DrMikeG/WiiBuzz/readme_img/IMG_20190727_184134.jpg

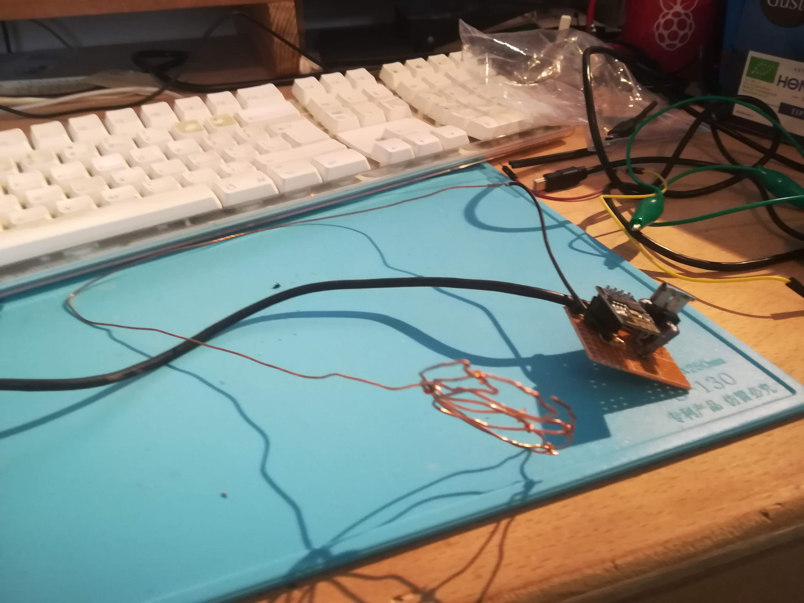
readme_img/IMG_20190727_184134.jpg
