DrMikeG/WiiBuzz/WebPageAP/WebPageAP.ino

// Load Wi-Fi library
#include <ESP8266WiFi.h>
#include <ESP8266mDNS.h>        // Include the mDNS library

const char* ssid = "VM4826469";
const char* password = "z8gGpcvqjhpk";

// Set web server port number to 8080
WiFiServer server(80);

// Variable to store the HTTP request
String header;

// Auxiliar variables to store the current output state
String output2State = "off";
String output0State = "on";

// Assign output variables to GPIO pins
const int output0 = 0;
const int output2 = 2;

//IPAddress local_IP(192,168,0,45);
//IPAddress gateway(192,168,0,9);
//IPAddress subnet(255,255,255,0);

void setup() {
  Serial.begin(115200);
  // Initialize the output variables as outputs
  pinMode(output2, OUTPUT);
  pinMode(output0, OUTPUT);
  // Set outputs to LOW
  digitalWrite(output2, LOW);
  digitalWrite(output0, HIGH);

  // Connect to Wi-Fi network with SSID and password
  //Serial.print("Connecting to ");
  //Serial.println(ssid);
  //WiFi.begin(ssid, password);
  //while (WiFi.status() != WL_CONNECTED) {
  //  delay(500);
  //  Serial.print(".");
  //}
  Serial.print("Setting soft-AP configuration ... ");
  Serial.println(WiFi.softAPConfig(local_IP, gateway, subnet) ? "Ready" : "Failed!");

  Serial.print("Setting soft-AP ... ");
  Serial.println(WiFi.softAP("ManCaveIOT","z8gGpcvqjhpk") ? "Ready" : "Failed!");

  Serial.print("Soft-AP IP address = ");
  Serial.println(WiFi.softAPIP());
  
  // Print local IP address and start web server
  //Serial.println("");
  //Serial.println("WiFi connected.");
  //Serial.println("IP address: ");
  //Serial.println(WiFi.localIP());
  //Serial.print("Setting soft-AP ... ");
  //boolean result = WiFi.softAP("ManCaveIOT","z8gGpcvqjhpk");
  //if(result == true)
  //{
  //  Serial.println("Ready");
  //}
  //else
  //{
   // Serial.println("Failed!");
  //}

  if (!MDNS.begin("mancave")) {             // Start the mDNS responder for mancave.local 
    Serial.println("Error setting up MDNS responder!");
  }
  Serial.println("mDNS responder started");
   // Add service to MDNS-SD
  MDNS.addService("http", "tcp", 80);
  server.begin();
}

void loop(){
  
  //Serial.printf("Stations connected = %d\n", WiFi.softAPgetStationNum());
  
  WiFiClient client = server.available();   // Listen for incoming clients

  if (client) {                             // If a new client connects,
    Serial.println("New Client.");          // print a message out in the serial port
    String currentLine = "";                // make a String to hold incoming data from the client
    while (client.connected()) {            // loop while the client's connected
      if (client.available()) {             // if there's bytes to read from the client,
        char c = client.read();             // read a byte, then
        Serial.write(c);                    // print it out the serial monitor
        header += c;
        if (c == '\n') {                    // if the byte is a newline character
          // if the current line is blank, you got two newline characters in a row.
          // that's the end of the client HTTP request, so send a response:
          if (currentLine.length() == 0) {
            // HTTP headers always start with a response code (e.g. HTTP/1.1 200 OK)
            // and a content-type so the client knows what's coming, then a blank line:
            client.println("HTTP/1.1 200 OK");
            client.println("Content-type:text/html");
            client.println("Connection: close");
            client.println();
            
            // turns the GPIOs on and off
            if (header.indexOf("GET /2/on") >= 0) {
              Serial.println("GPIO 2 on");
              output2State = "on";
              digitalWrite(output2, HIGH);
            } else if (header.indexOf("GET /2/off") >= 0) {
              Serial.println("GPIO 2 off");
              output2State = "off";
              digitalWrite(output2, LOW);
            } else if (header.indexOf("GET /0/on") >= 0) {
              Serial.println("GPIO 0 on");
              output0State = "on";
              digitalWrite(output0, HIGH);
            } else if (header.indexOf("GET /0/off") >= 0) {
              Serial.println("GPIO 0 off");
              output0State = "off";
              digitalWrite(output0, LOW);
            } else if (header.indexOf("GET /flash") >= 0) {
              // Flash 10 times

              for (int i=0; i < 20; i++)
              {
                digitalWrite(output0, LOW); // LEDS on              
                delay(350);
                Serial.println("FLASH!");
                digitalWrite(output0, HIGH); // LEDS off    
                delay(100);
              }
              
              Serial.println("GPIO 0 on");
              output0State = "on";
              digitalWrite(output0, HIGH);              
            }
            
            // Display the HTML web page
            client.println("<!DOCTYPE html><html>");
            client.println("<head><meta name=\"viewport\" content=\"width=device-width, initial-scale=1\">");
            client.println("<link rel=\"icon\" href=\"data:,\">");
            // CSS to style the on/off buttons 
            // Feel free to change the background-color and font-size attributes to fit your preferences
            client.println("<style>html { font-family: Helvetica; display: inline-block; margin: 0px auto; text-align: center;}");
            client.println(".button { background-color: #195B6A; border: none; color: white; padding: 16px 40px;");
            client.println("text-decoration: none; font-size: 30px; margin: 2px; cursor: pointer;}");
            client.println(".button2 {background-color: #77878A;}</style></head>");
            
            // Web Page Heading
            client.println("<body><h1>ESP8266 Web Server</h1>");
            
            // Display current state, and ON/OFF buttons for GPIO 2  
            client.println("<p>GPIO 2 - State " + output2State + "</p>");
            // If the output2State is off, it displays the ON button       
            if (output2State=="off") {
              client.println("<p><a href=\"/2/on\"><button class=\"button\">ON</button></a></p>");
            } else {
              client.println("<p><a href=\"/2/off\"><button class=\"button button2\">OFF</button></a></p>");
            } 
               
            // Display current state, and ON/OFF buttons for GPIO 4  
            client.println("<p>GPIO 0 - State " + output0State + "</p>");
            // If the output0State is off, it displays the ON button       
            if (output0State=="off") {
              client.println("<p><a href=\"/0/on\"><button class=\"button\">ON</button></a></p>");
            } else {
              client.println("<p><a href=\"/0/off\"><button class=\"button button2\">OFF</button></a></p>");
            }

            client.println("<p><a href=\"/flash\"><button class=\"button button3\">FLASH</button></a></p>");
            
            client.println("</body></html>");
            
            // The HTTP response ends with another blank line
            client.println();
            // Break out of the while loop
            break;
          } else { // if you got a newline, then clear currentLine
            currentLine = "";
          }
        } else if (c != '\r') {  // if you got anything else but a carriage return character,
          currentLine += c;      // add it to the end of the currentLine
        }
      }
    }
    // Clear the header variable
    header = "";
    // Close the connection
    client.stop();
    Serial.println("Client disconnected.");
    Serial.println("");
  }
}
