DrMikeG/WiiBuzz/(commit log)

2019-06-11 Updated Switch Client to flash onboard LED
2019-06-29 Solder on hex invertor
2019-07-05 Finished circuit and assembled torch
2019-07-25 changed switch URL to flash
2019-07-26 Work on capacitive switch code for nano and esp8266
2019-07-26 Included 3d printing images
2019-09-15 first arduino sketch not working
    [ArduinoRCSketch.ino]
2019-09-15 Saving pihit socket codes
2019-09-15 Notes on rc-switch codes
2019-09-15 Moved notes into ArduinoRC Readme
2019-09-16 Connecting to wifi and switching on pin 3
2019-10-05 Rejiging EspTwitterPoster to use PWM in loop()
2020-02-21 Fixing hang in EspRCSketch
    [EspRCSketch.ino, EspTwitterPosterPIR.ino]
